ryood/C88/P1080458.jpg

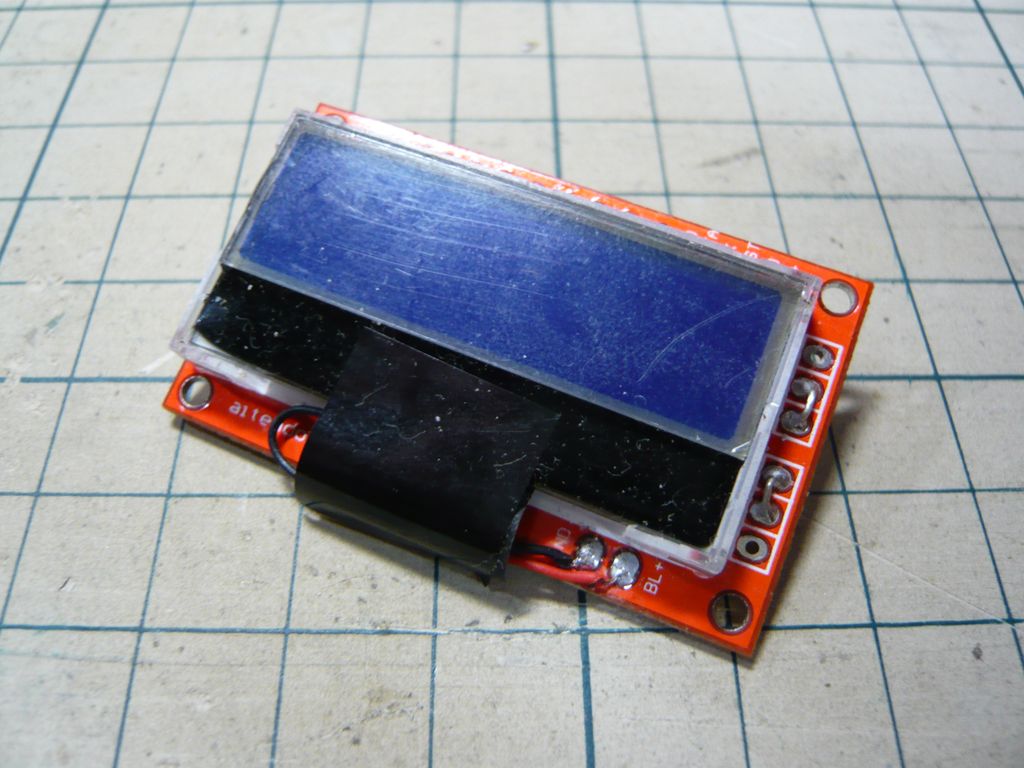
P1080458.jpg
