ryood/C88/P1080450.jpg

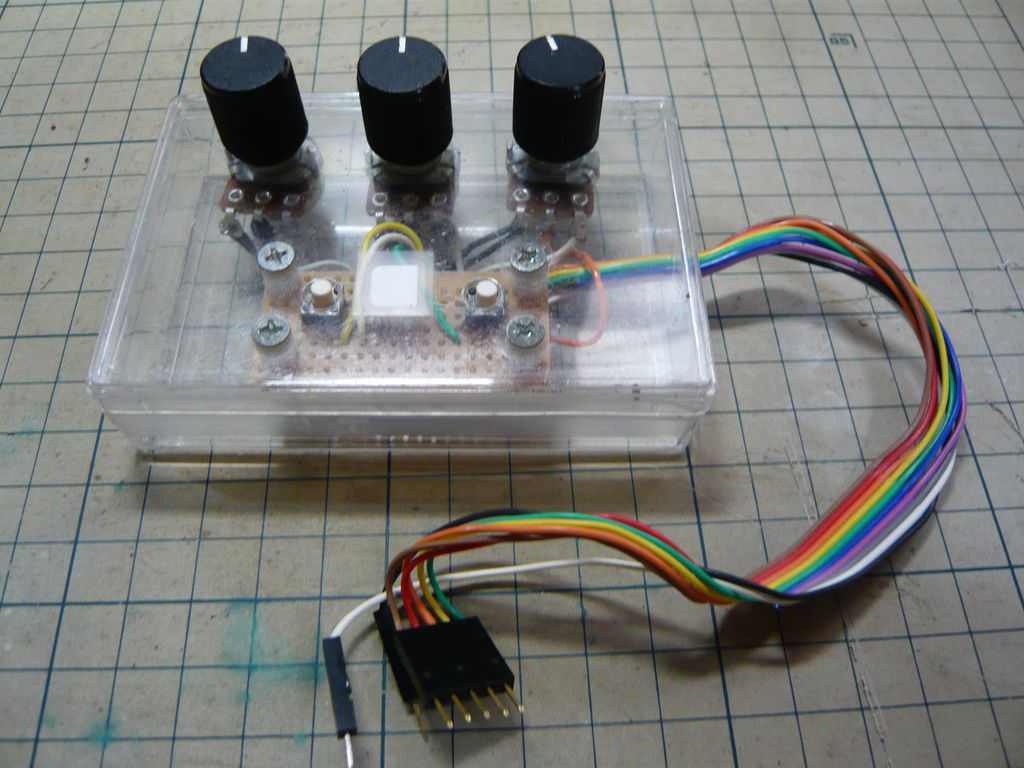
P1080450.jpg
