ryood/C88/DDS.pptx

Direct Digital Synthesis(DDS)

LSB

Bit 0

Bit 1

…

Bit 30

Bit 31

Sample
Clock

Desired
Frequenchy

Phase
Accumlator
(32bit)

32bit

10bit

Phase
Register

Lookup
Table

8bit

DAC

MSB
