ryood/C88/名刺.pdf

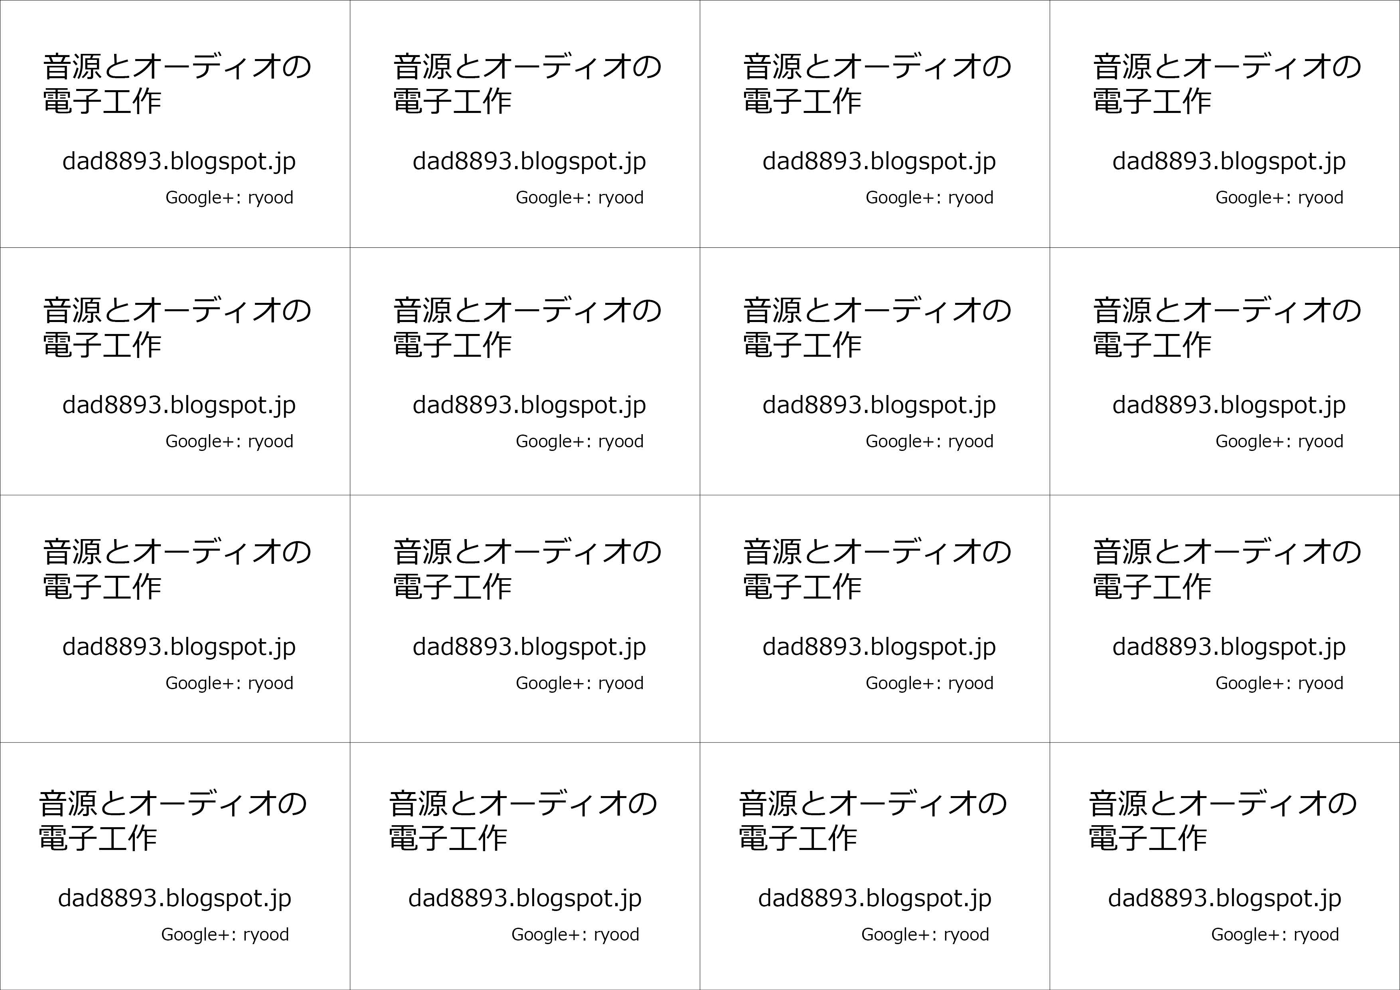
[picture p34: page 1]
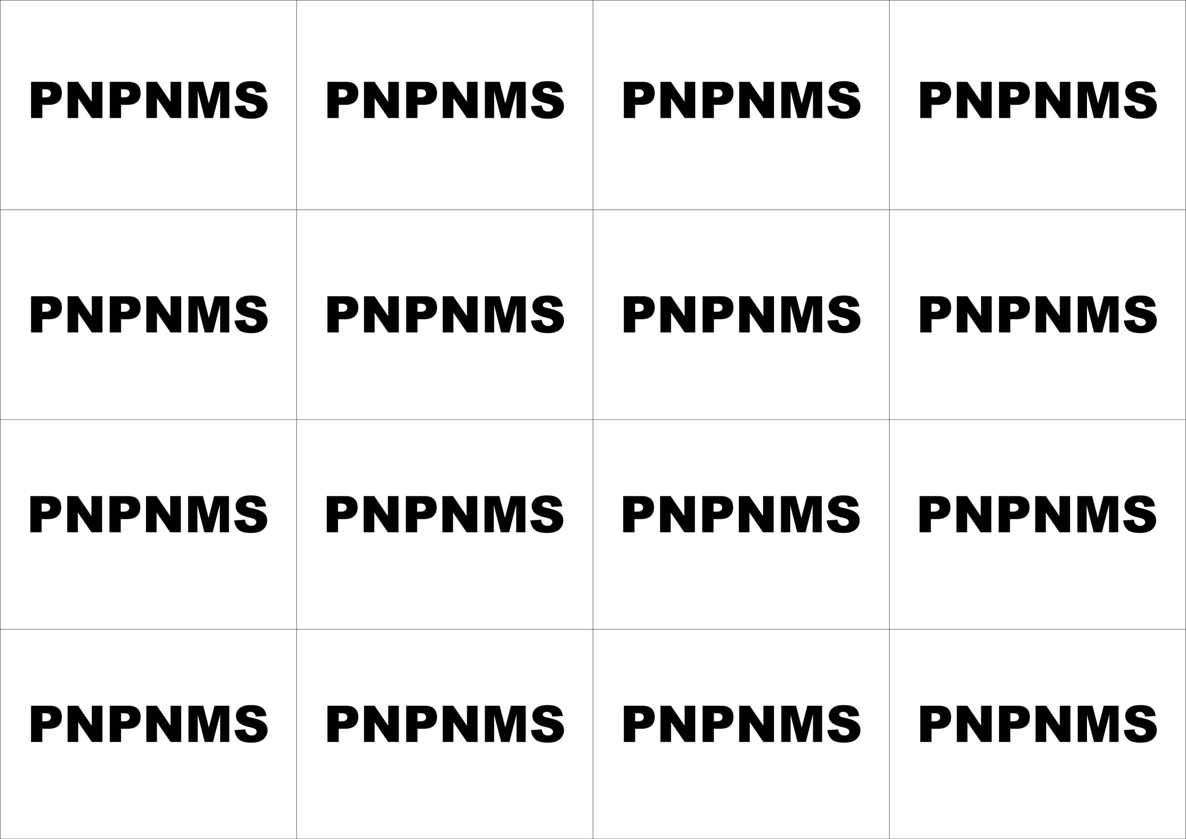
[picture p35: page 2]
