ryood/C88/3rd-VCVS-LPF.png

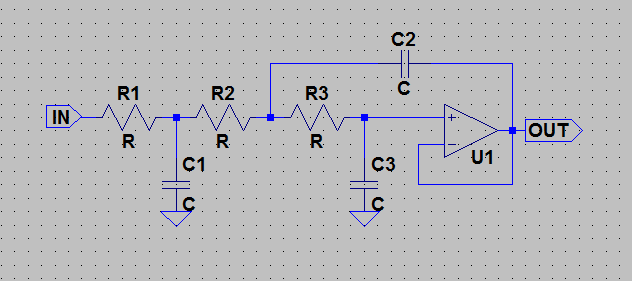
3rd-VCVS-LPF.png
