ryood/C88/C88_Repo/IMG_20150816_141525.jpg

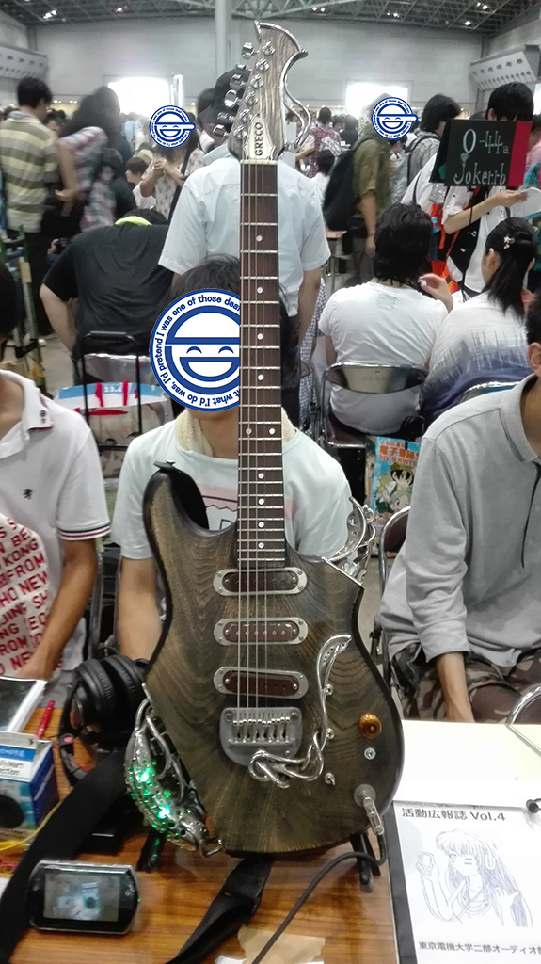
C88_Repo/IMG_20150816_141525.jpg
