ryood/C88/C88_Repo/P1080546.jpg

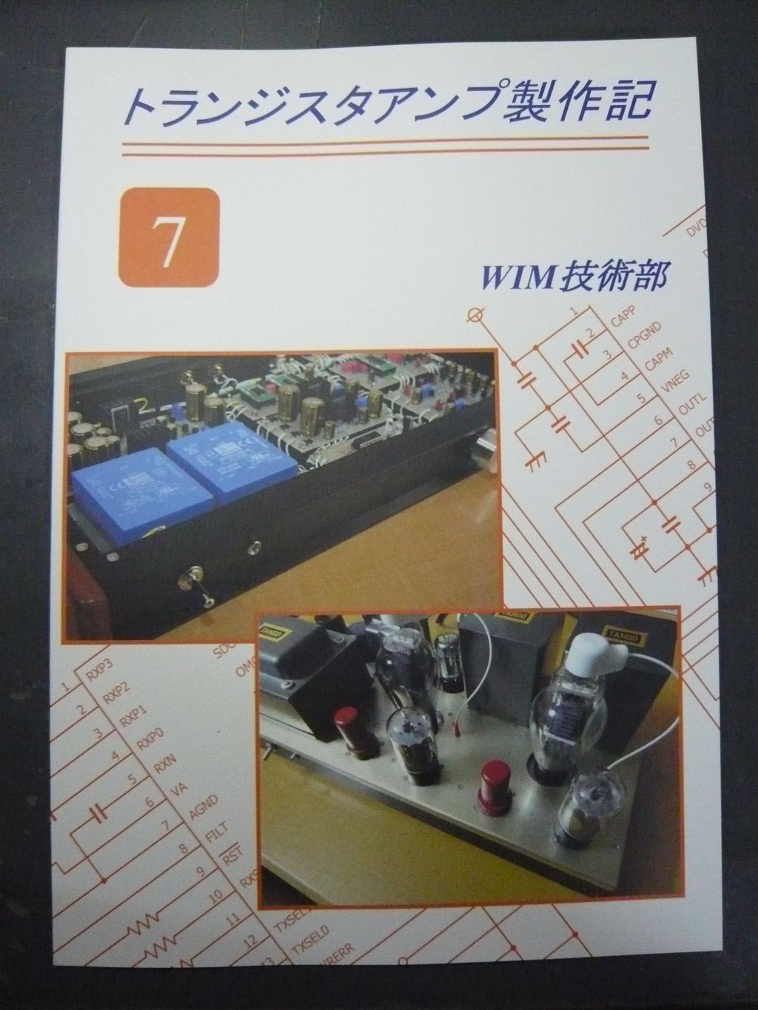
C88_Repo/P1080546.jpg
