ryood/C88/C88_Repo/P1080547.jpg

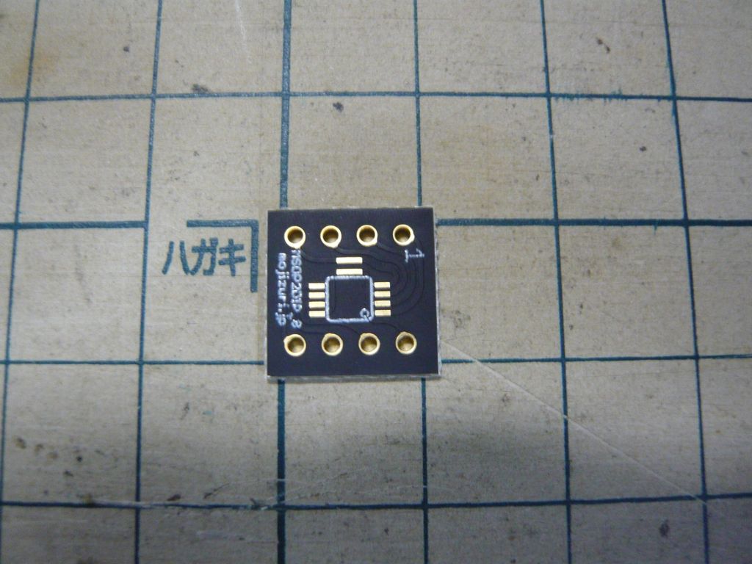
C88_Repo/P1080547.jpg
