ryood/C88/C88_Repo/P1080556.jpg

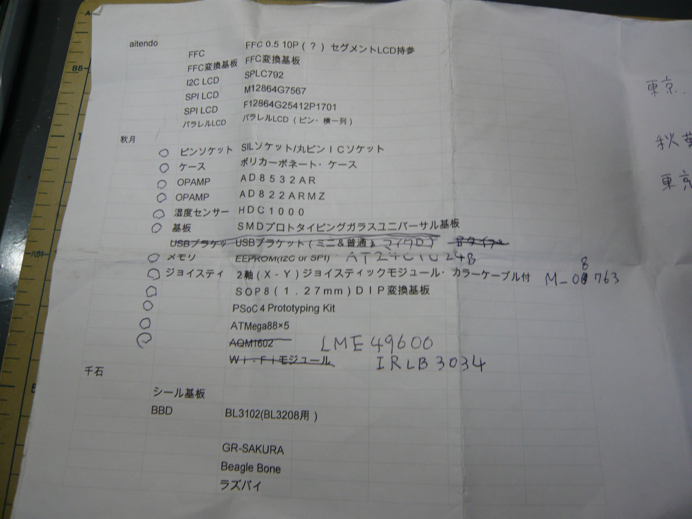
C88_Repo/P1080556.jpg
