ryood/C88/C88_Repo/P1080560.jpg

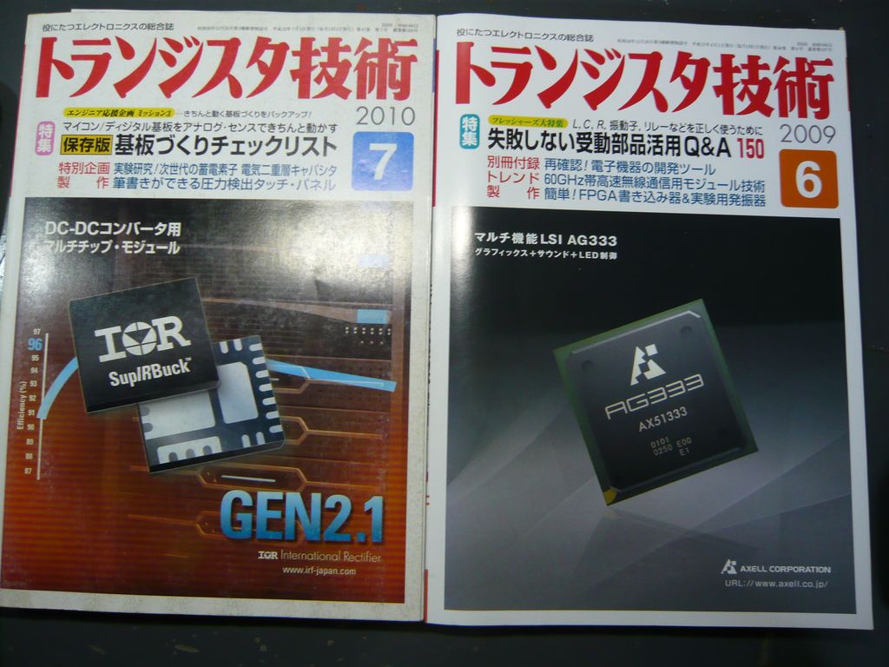
C88_Repo/P1080560.jpg
