ryood/C88/C88_Repo/P1080577.jpg

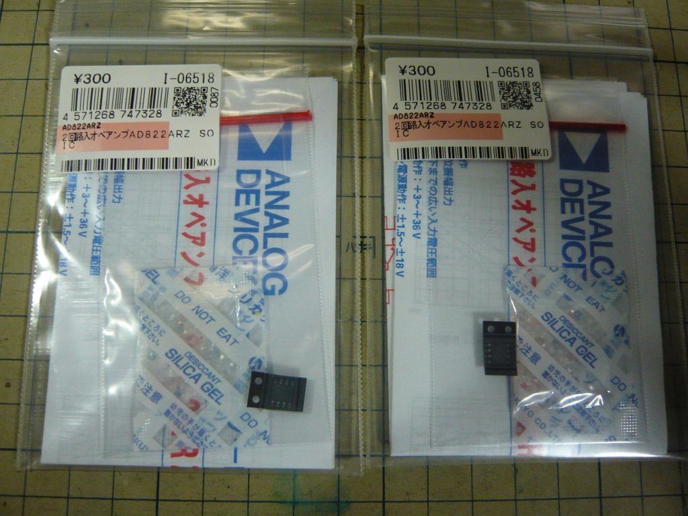
C88_Repo/P1080577.jpg
