ryood/C88/C88_Repo/P1080593.jpg

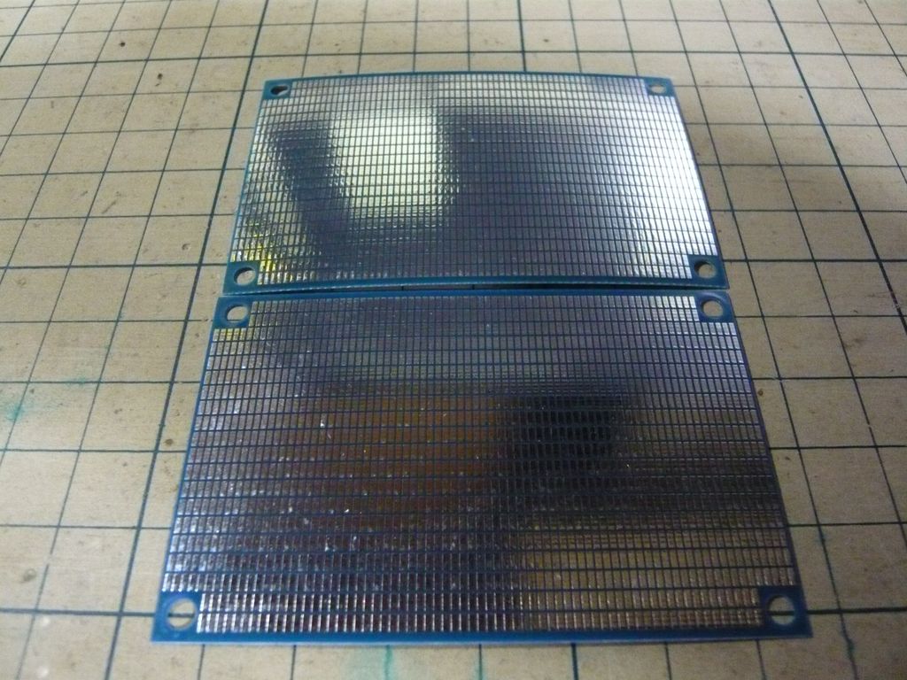
C88_Repo/P1080593.jpg
