ryood/C88/C88_Repo/P1080596.jpg

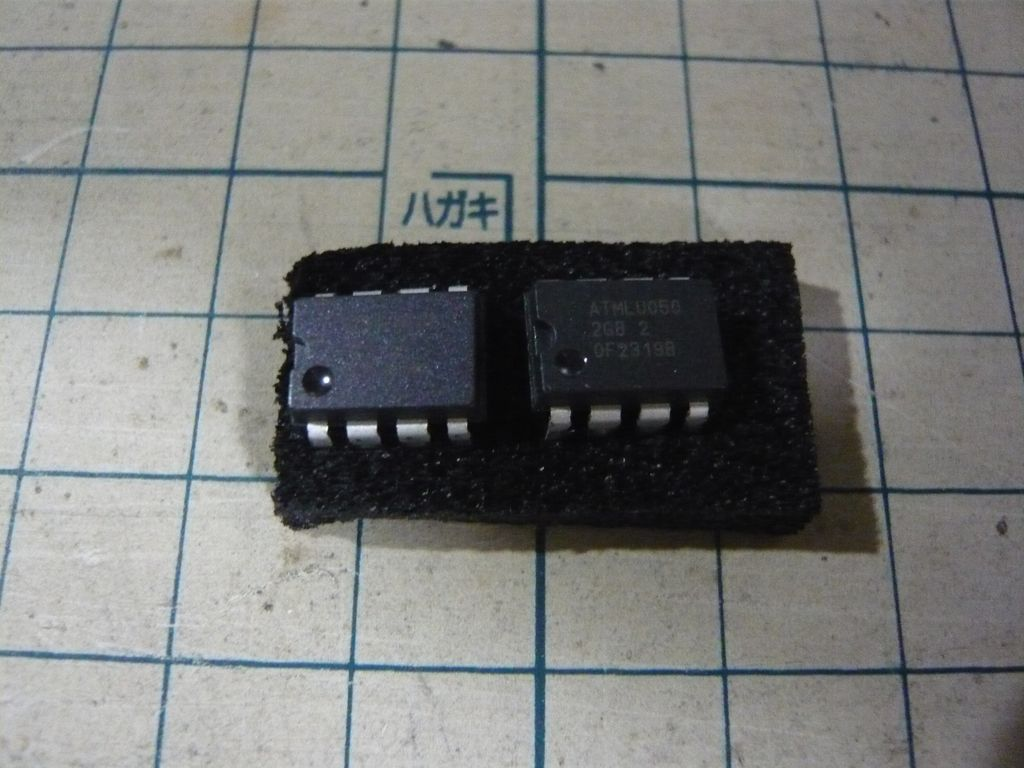
C88_Repo/P1080596.jpg
