ryood/C88/C88_Repo/P1080614.jpg

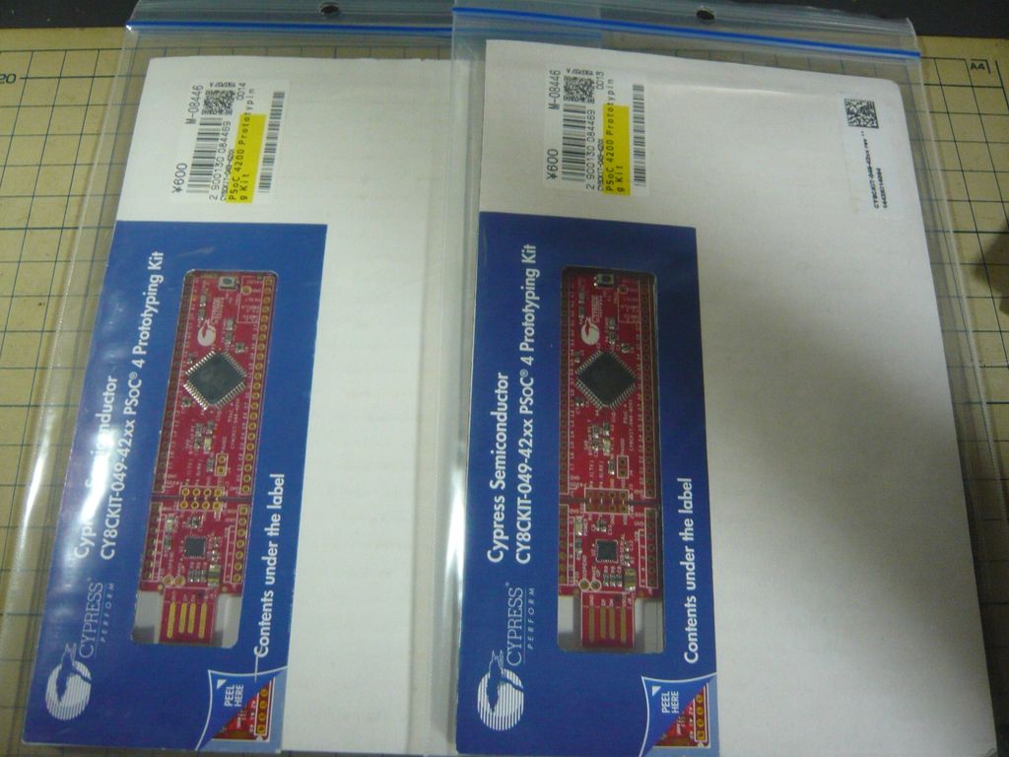
C88_Repo/P1080614.jpg
