ryood/C88/C88_Repo/P1080615.jpg

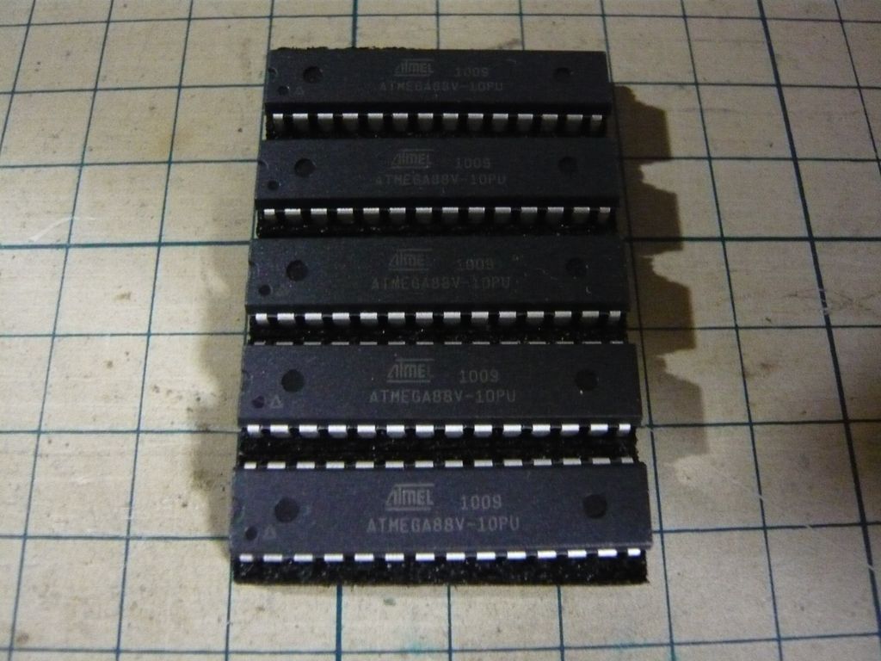
C88_Repo/P1080615.jpg
