ryood/C88/C88_Repo/P1080623.jpg

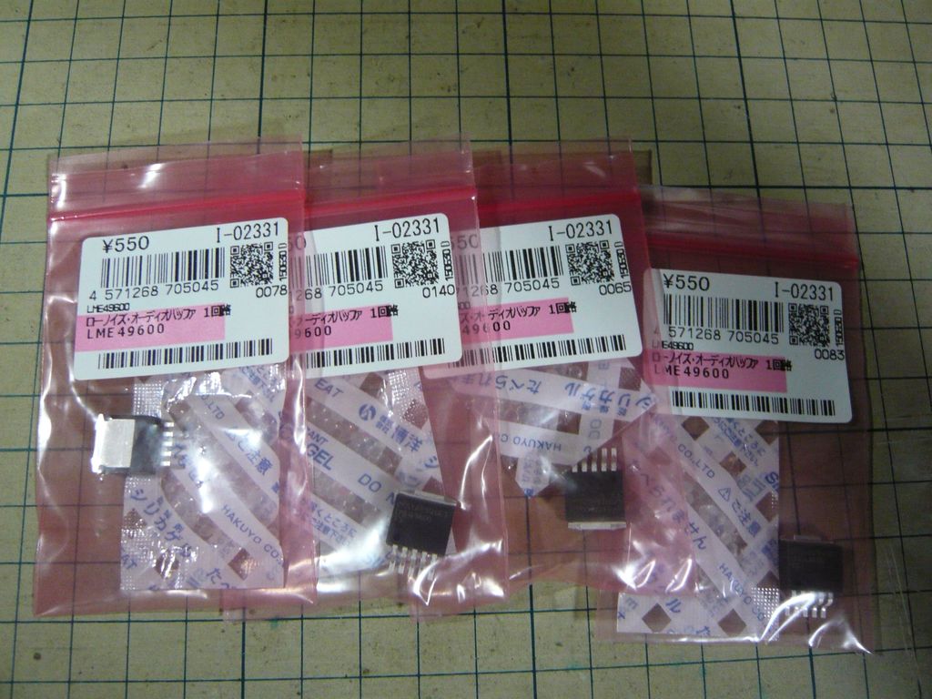
C88_Repo/P1080623.jpg
