ryood/C88/C88_Repo/P1080634.jpg

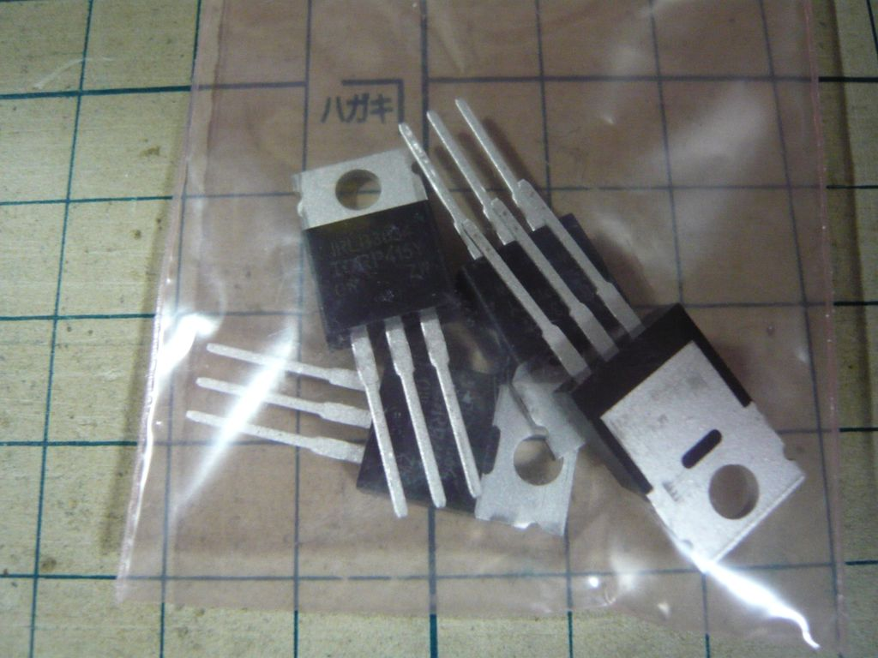
C88_Repo/P1080634.jpg
