ryood/C88/C88_Repo/P1080648.jpg

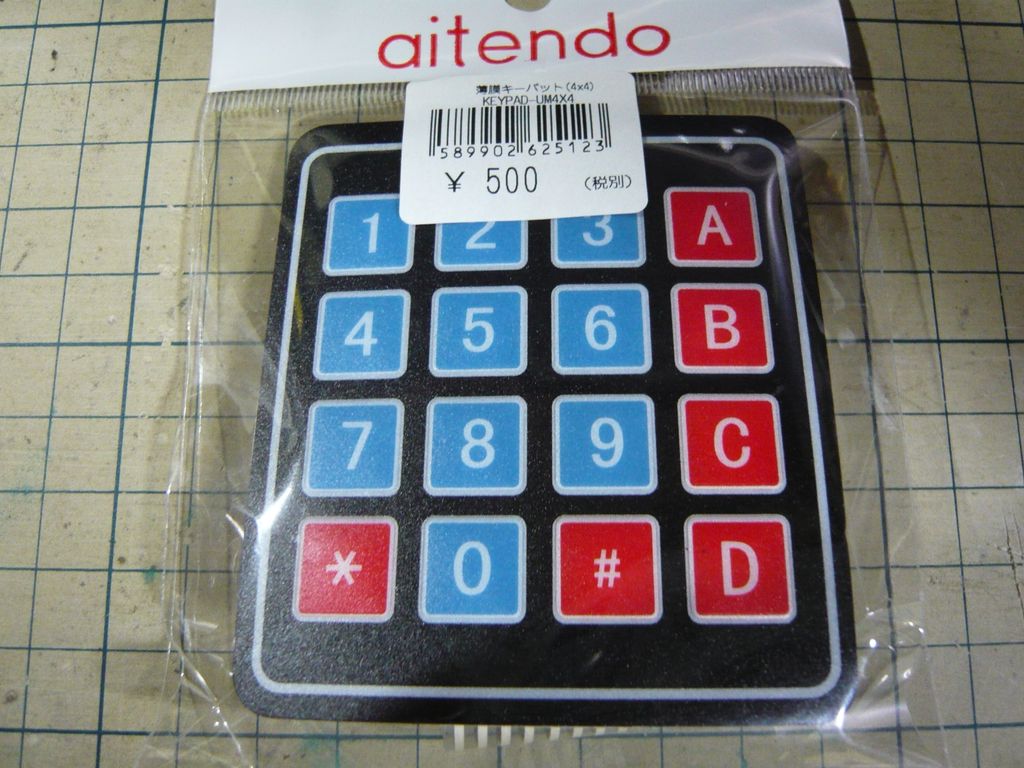
C88_Repo/P1080648.jpg
