ryood/C88/C88_Repo/P1080659.jpg

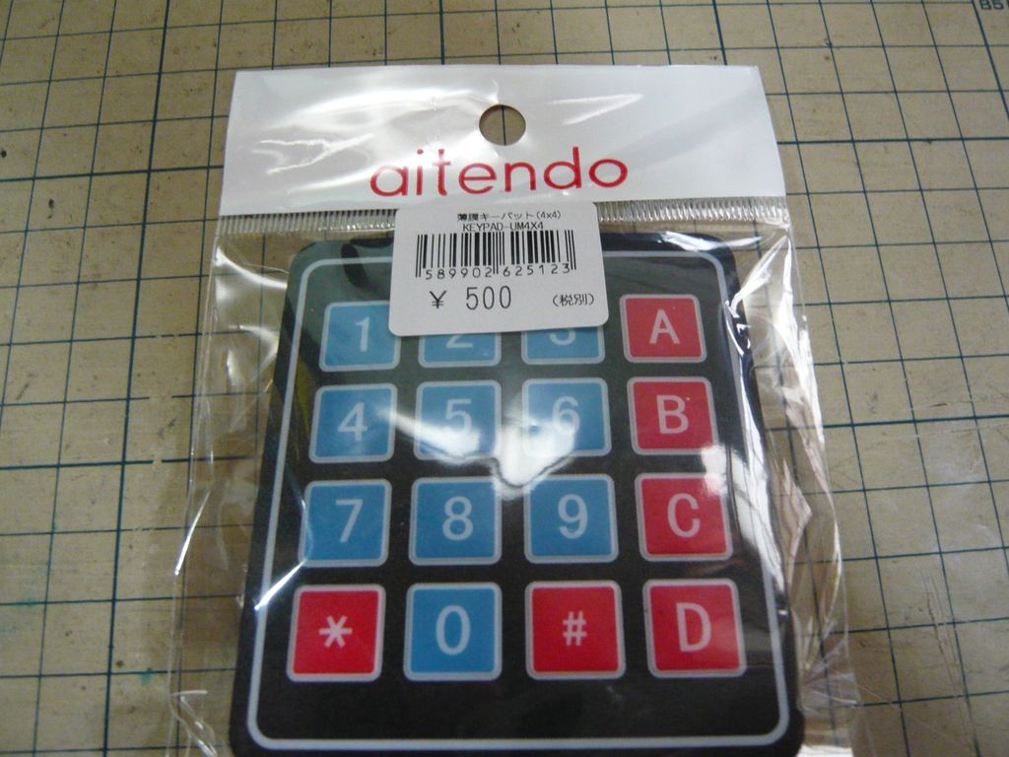
C88_Repo/P1080659.jpg
