ryood/C88/C88_Repo/P1080672.jpg

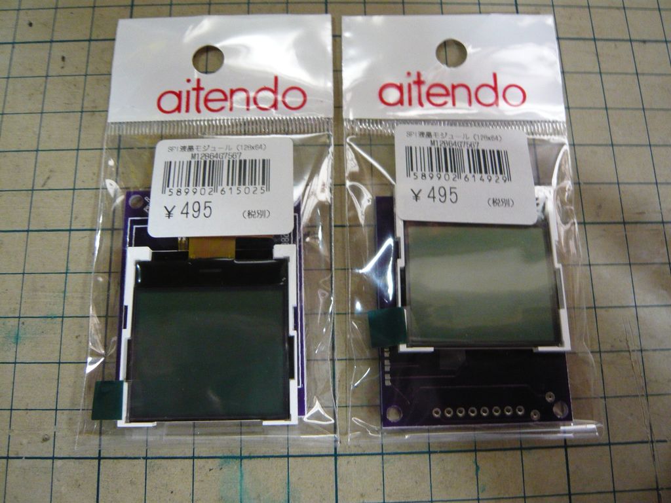
C88_Repo/P1080672.jpg
