ryood/C88/C88_Repo/P1080675.jpg

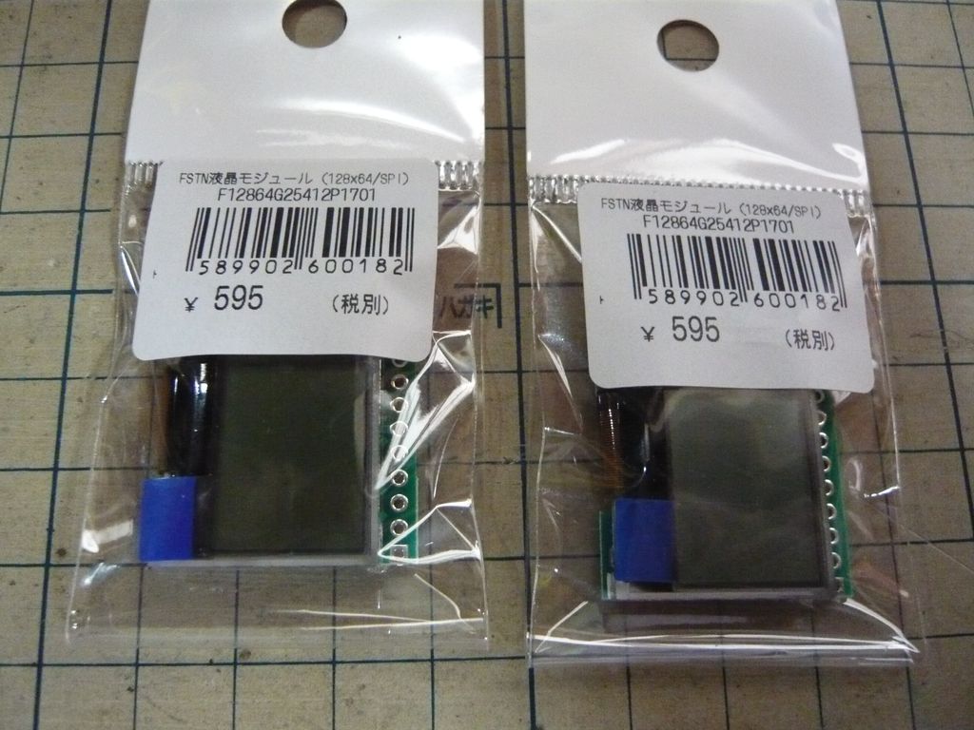
C88_Repo/P1080675.jpg
