ryood/C88/C88_Repo/P1080678.jpg

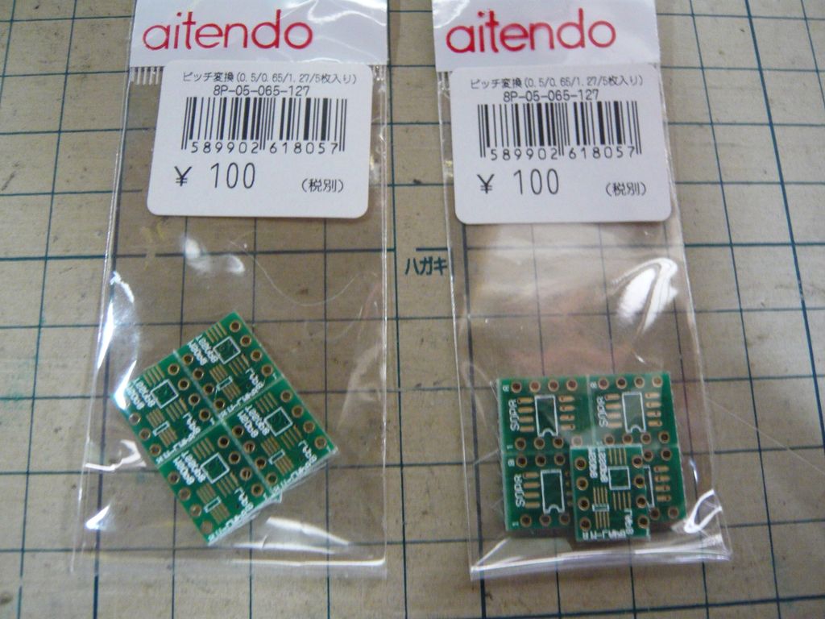
C88_Repo/P1080678.jpg
