ryood/C88/C88_Repo/P1080686.jpg

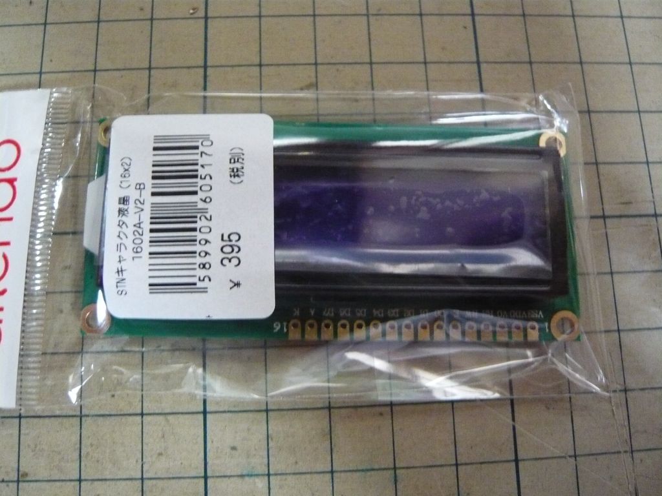
C88_Repo/P1080686.jpg
