ryood/C88/C88_Repo/P1080692.jpg

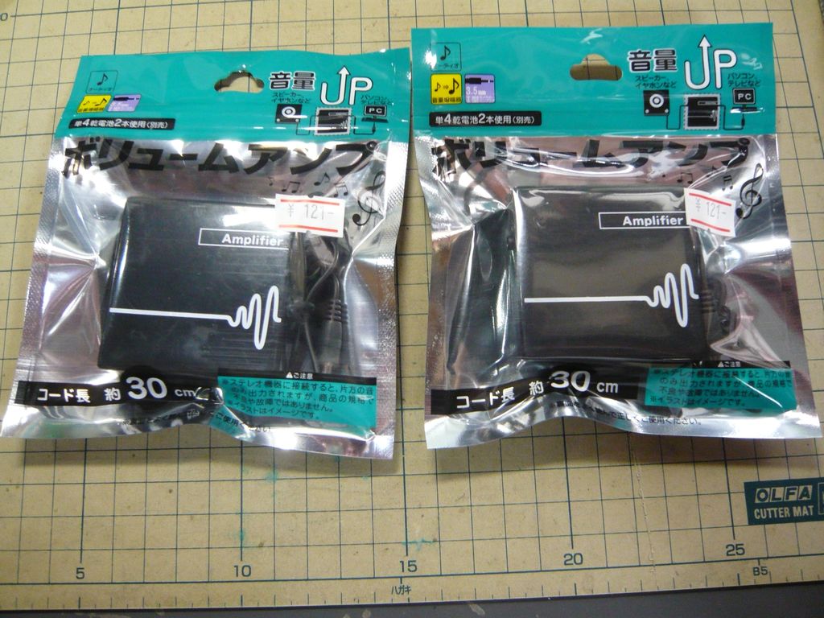
C88_Repo/P1080692.jpg
