ryood/C88/C88_Tanzaku2.png

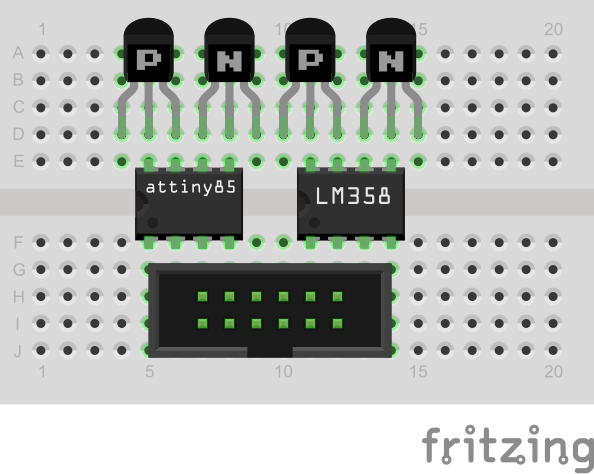
C88_Tanzaku2.png
