ryood/C88/C88_Tanzaku.png

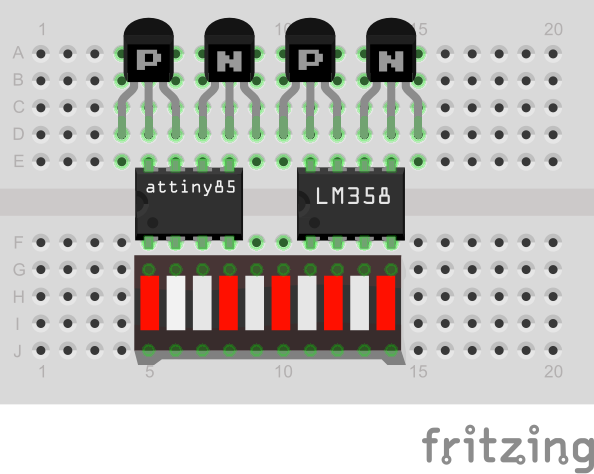
C88_Tanzaku.png
