ryood/C88/I-V Convert.png

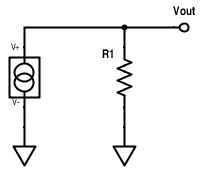
I-V Convert.png
