ryood/C88/IMG.jpg

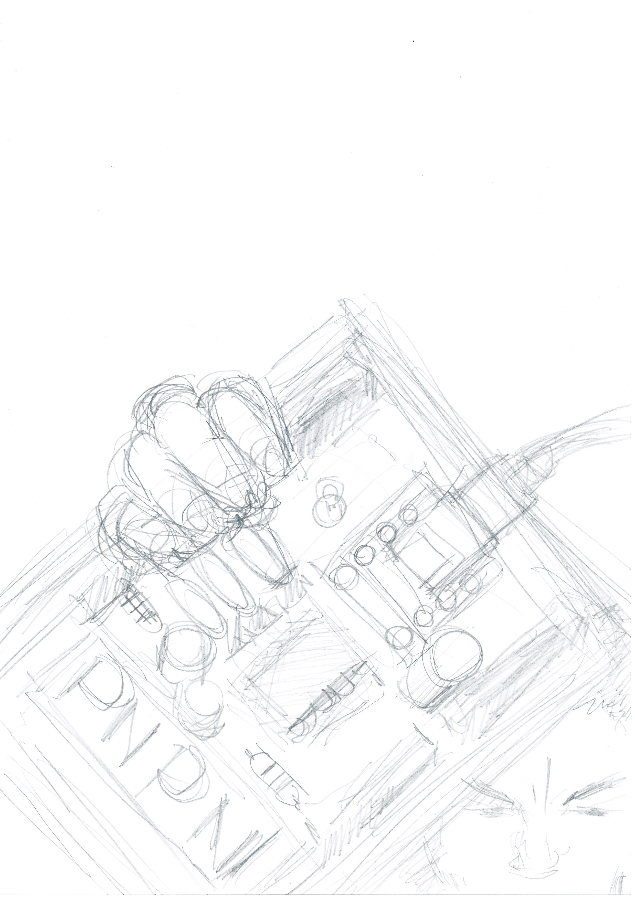
IMG.jpg
