ryood/C88/ぴゅんぴゅん３号.jpg

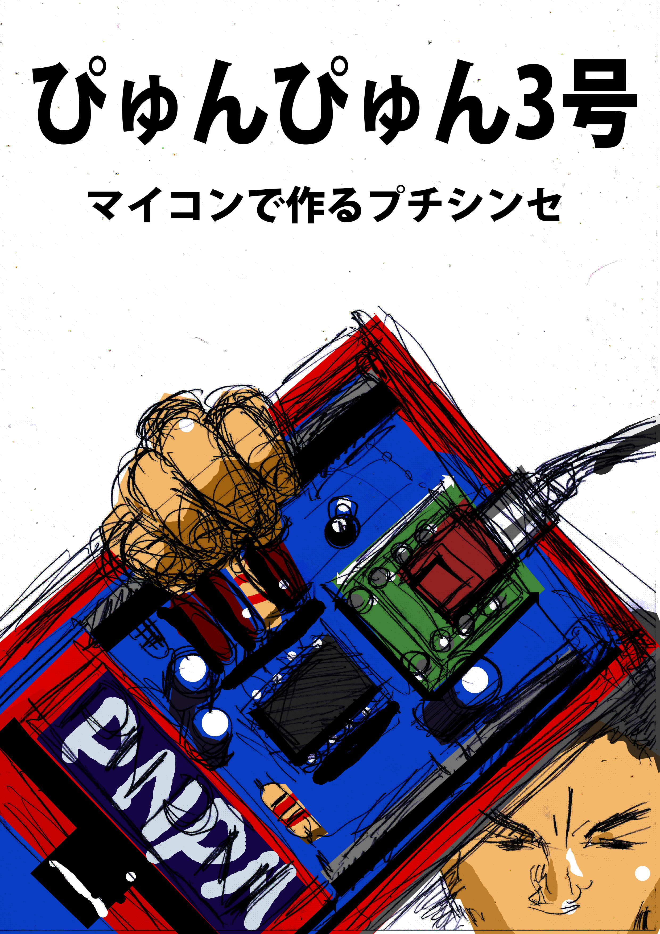
ぴゅんぴゅん３号.jpg
