ryood/C88/みほん.png

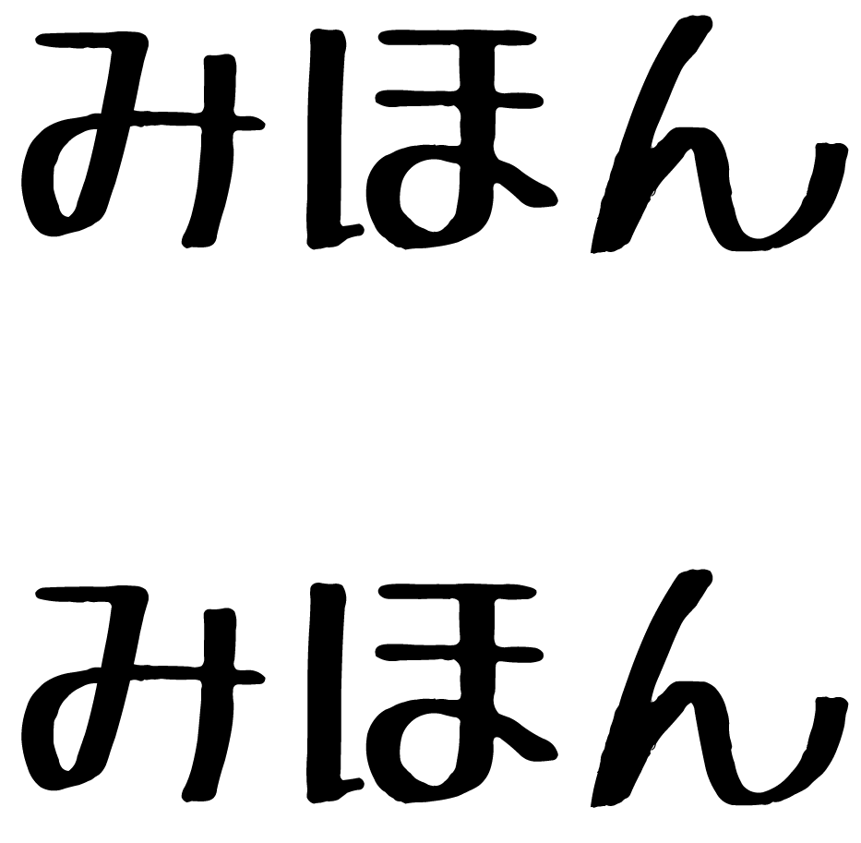
みほん.png
