ryood/C88/Publish/PSoC-PyunPyun-3rdLPF-master/LTSpice/3rd-VCVS-LPF-50kHz.asc

C1: cap; 560p
C2: cap; 100p
C3: cap; 22p
R1: res; 10k
R2: res; 100k
R3: res; 33k
U1: UniversalOpamp2
V1: voltage; ""; AC 1
Named nets: 0, IN, OUT
.ac oct 20 10 1Meg
