ryood/C88/(list of files, drawings)

Other design files:
PNPNMS.fzz
Publish/PSoC-PyunPyun-3rdLPF-master/Fritzing/PSoC_PyunPyun_3rdLPF.fzz
