ryood/C88/(commit log)

2015-08-07 ドキュメントを修正
2015-08-07 aveファイルを追加
